BigManRaffa/Clementine/bringup/README.md

# Clementine Pre-Silicon Validation

- ALU, decoder, lanes, fetch sequencer, register file, SPI slave, multiplier, and mask stack end-to-end validated using a ESP32-S3 Devboard and a Gowin GW2AR FPGA (Sipeed Tang Nano 20K GW2AR-LV18QN88C8/I7).
- Inside [the host folder](bringup/host), a custom combined assembler + loader and a 39-kernel test suite were used to validate the entire ISA, grouped into per-lane identity, datapath, divergence, reverse-highway forms, and edge case tests.

## Validation Setup Diagrams

### Kernel Validation
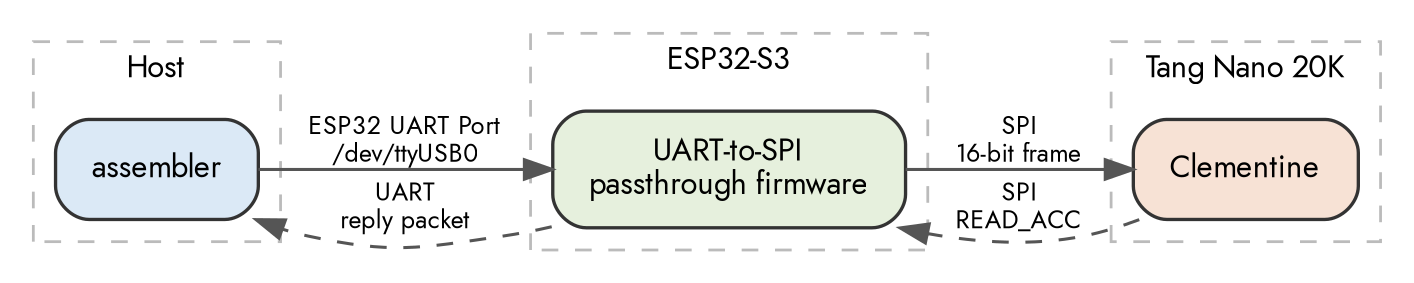
[picture p10: docs/bringup_diagram.png]
bringup diagram image


- The combined assembler + loader assembles a kernel and streams it to the ESP32 UART port one command per packet.

- The UART-to-SPI passthrough firmware on the ESP32 then unwraps each packet, drives the opcode onto Clementine's three command pins, and clocks the payload out over SPI.

- Clementine then loads each instruction word into its 8-slot buffer, runs the kernel across four lanes once the assembler tells it to start, and holds the results in its four accumulators. 

- The assembler polls until the chip reports it has halted, then requests each lane in turn, shifting that accumulator out on MISO for the ESP32 firmware to return as a UART reply packet.

### DOOM Desktop Demo

doom dataflow image

- The header generators bake the DOOM1.WAD into three headers, E1M1's BSP tree and per wall segment sector heights, a Q0.7 sine table, and the HUD as RGB565, which are then compiled into the sketch and flashed over the ESP32 UART Port. 

- The doom_driver handles visibility and marshalling. It walks the BSP tree front-to-back so nearer walls claim columns first, culls backfacing wall segments before spending a single SPI frame on them, then packs each wall's endpoints into int8 camera-relative coordinates and streams them over SPI as EXEC and BUFFER frames.

- Clementine takes those endpoints and does every multiply and divide that puts a wall on screen. It rotates two wall segments at once across its four lanes, dividing by multiplying with a reciprocal, projects each ceiling and floor to a screen row, then computes coverage for every wall edge with SIMT MAC instructions, working out how much of the boundary cell the wall actually covers.

- The driver reads those rows back over MISO and does the scan conversion, filling the cells between edges Clementine returned, then drives the panel by comparing the character grid against the previous frame and blitting only the runs that changed. 

- Those pixels leave as READ_ACC transactions on the same MISO line the ST7789 listens on, so every byte the panel receives is shifted out of Clementine's accumulator.

## Validation Setup image

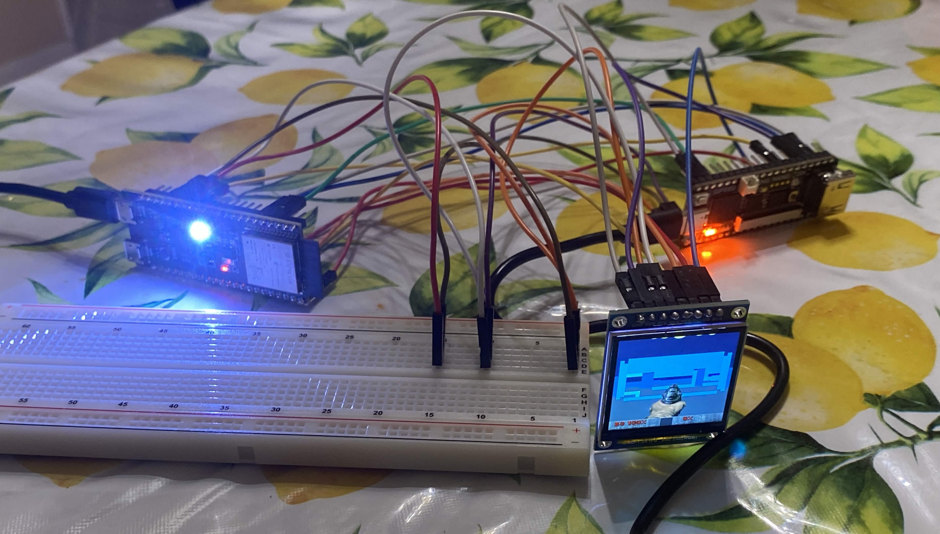
[picture p11: docs/bringup.jpg]
bringup image


## Old Demo

https://github.com/user-attachments/assets/2a935765-3c63-42a5-b818-157d14847543

## Breadboard Setup

### Wiring

Three shared-bus nodes, each one breadboard column with three wires:

| Node | Driver | Listeners |
|---|---|---|
| SCLK | ESP32 GPIO12 | Tang pin 73, LCD SCL |
| MISO | Tang pin 75 | ESP32 GPIO13, LCD SDA |
| MOSI | ESP32 GPIO11 | Tang pin 74 |

Point-to-point:

| Signal | ESP32 | Tang Nano 20K |
|---|---|---|
| CS_N | GPIO9 | pin 76 |
| CMD0 | GPIO4 | pin 86 |
| CMD1 | GPIO5 | pin 72 |
| CMD2 | GPIO6 | pin 71 |
| GND | G | GND |

| LCD | Connects to |
|---|---|
| CS | ESP32 GPIO38 |
| DC | ESP32 GPIO42 |
| RES | ESP32 GPIO41 |
| VCC | Tang 3V3 |
| BLK | Tang 3V3 |
| GND | Tang GND |

On-board, no wires: clk = Tang pin 4 (27 MHz oscillator, PLL'd to 40.5 MHz), rst_n = pin 88 (button S1), LEDs = pins 15-18.

This setup ALSO works for the assembler + kernel tests aswell.

## Doom Handheld Demo

## Handheld

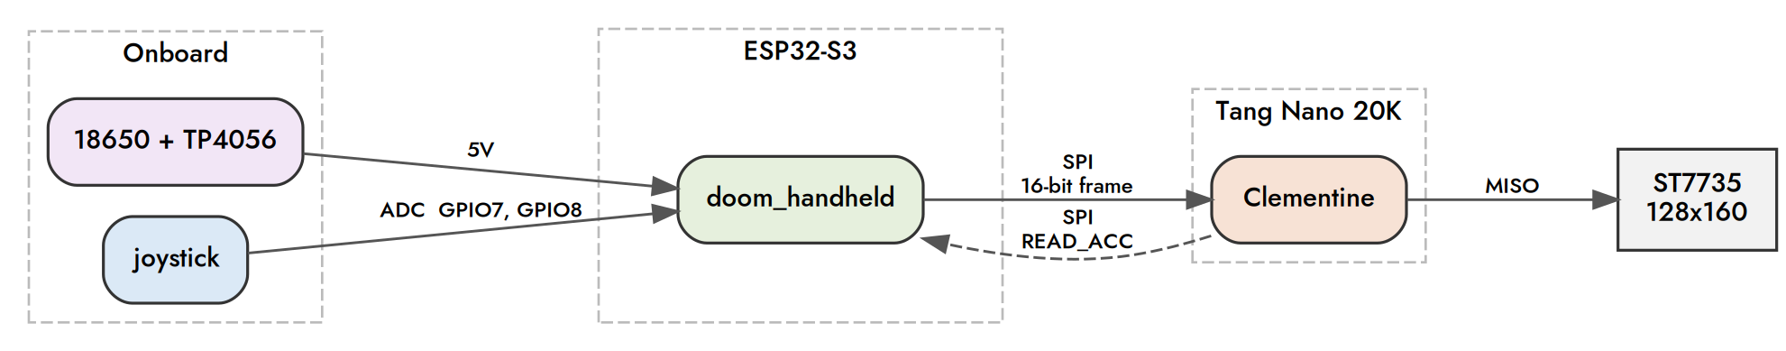
[picture p12: docs/handheld_dataflow.png]
handheld data flow


* Same renderer, retargeted to a 128x160 ST7735 and made self contained. The
  laptop is gone, so there is no `walk.py`, no UART, and no serial input at
  all.

* The panel changes are two bytes and a grid. ST7735 wants `0x05` for RGB565
  where ST7789 wants `0x55`, and inversion off instead of on. Cells drop from
  8 pixels to 4, so a 32 by 40 grid fills the screen exactly with no
  letterboxing. The projection scale rises to keep the same field of view now
  that the screen is half as wide.

* Movement comes off an analog stick on two ADC pins. Every stick rests
  slightly off centre, so the firmware samples the resting position once at
  boot rather than assuming the midpoint. Do not touch it while it powers up.

* Each frame averages a burst of samples and runs them through a low pass,
  because a single ADC read swings tens of counts on a stick that has not
  moved. These gimbals also put a real signal on the other axis when pushed
  diagonally, which is enough to make a turn walk you backwards, so the axis
  you are not pushing has to clear a much higher threshold before it counts.

* The status bar is scaled so its height and width shrink by different amounts,
  because squeezing 320 pixels of bar into 128 leaves the digits unreadable at
  a uniform scale.

## Handheld image

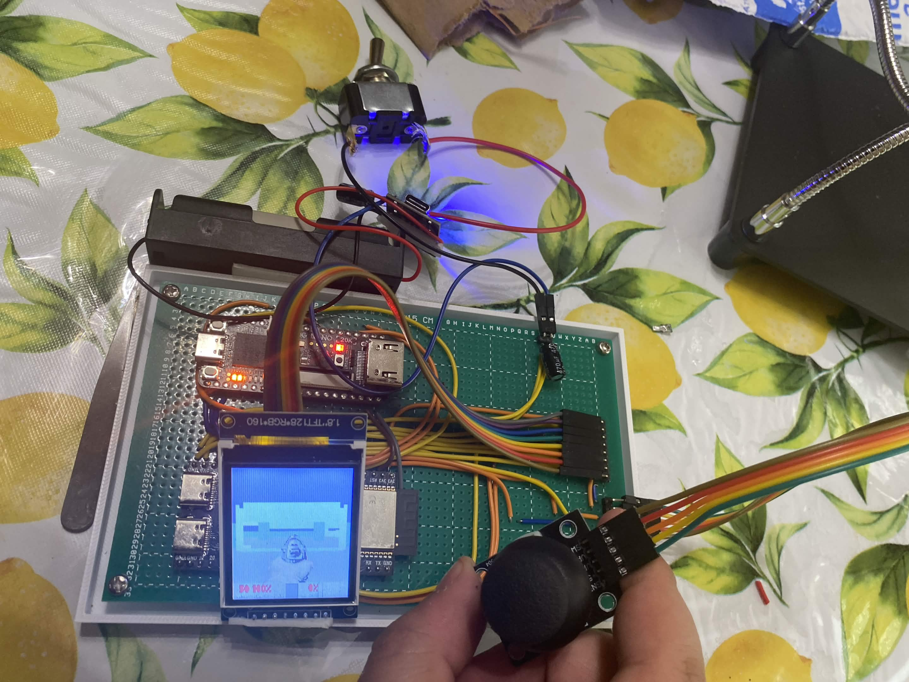
[picture p13: docs/handheld_image.jpg]
handheld data flow


Yes I used a SPST made for a car as my off switch please dont laugh at me.

### Wiring

Everything from the bench setup is unchanged. Three shared bus nodes, the four
command pins, and the LCD all wire as before. Two additions:

| Joystick | ESP32-S3 |
|---|---|
| GND | GND |
| +5V | 3V3 |
| VRX | GPIO7 |
| VRY | GPIO8 |
| SW  | GPIO14 |

The joystick's `+5V` pin is really VCC. The module is two potentiometers with
no regulator, so its output swings to whatever it is fed, and the ADC pins are
not 5V tolerant.

| Power | Connects to |
|---|---|
| TP4056 OUT+ | switch, then ESP32 5V and Tang 5V |
| TP4056 OUT- | ESP32 GND and Tang GND |

GPIO7 and GPIO8 are on ADC1, which keeps working when WiFi is enabled. ADC2
does not.

## Issues found

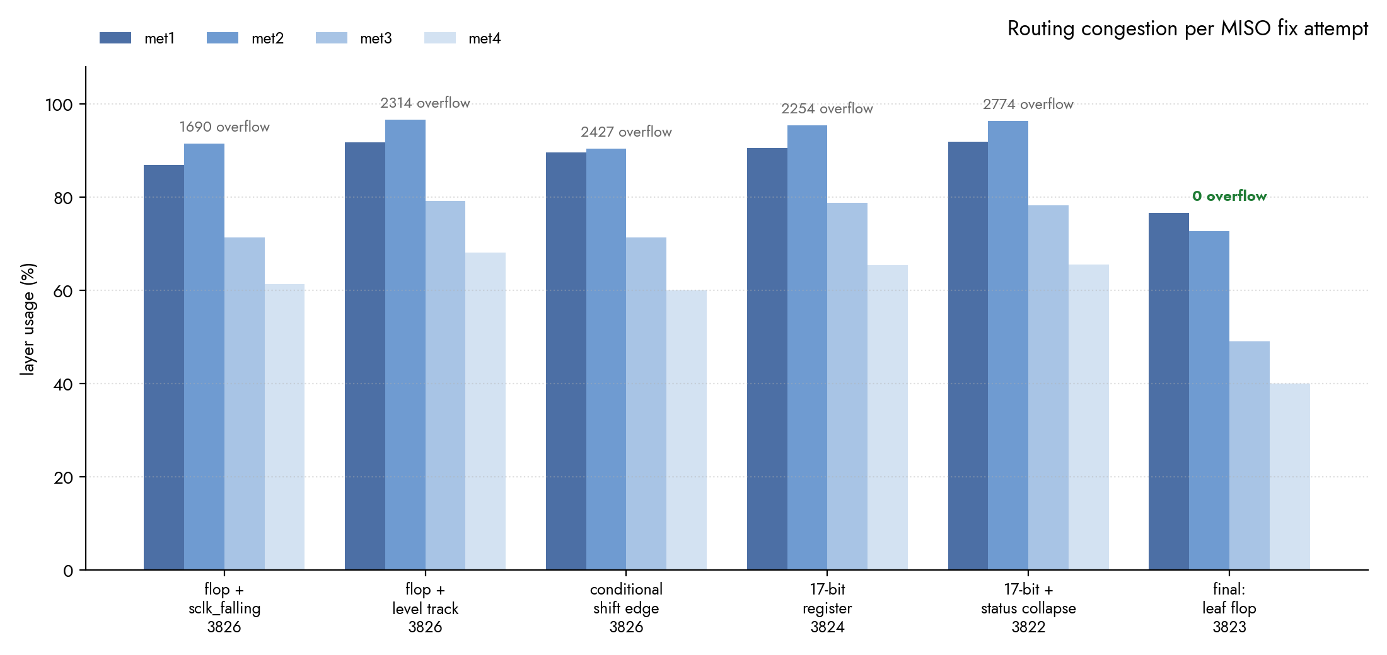
[picture p14: docs/congestion.png]
SPI debugging graph


- During Pre-Silicon Validation, a bug in the SPI module was found that the cocotb testbenches missed, MISO updated on the SCLK rising edge, the same one that master samples on. MISO was wired directly to the top bit of the shift register, with nothing in between. When the register shifted, MISO changed immediately, on the same clock edge the ESP32 was reading it. The master kept catching the next bit instead of the current one so every value came back doubled. 

    - To fix this, I first tried a dedicated miso_out flop that loaded the top of the selected read-back value at CS-fall and advanced on a new sclk_falling edge detector, which worked on the hardware pushed congestion from 61% to 81% with 1,690 overflow. 
    - Suspecting that the edge detector was the cost, I replaced it with a  simple check for whether the clock line was low, so the flop tracked the register the whole time SCLK was low and froze while it was high. Same cell count, but congestion got worse at 87% and 2314 overflow. 
    - I then tried removing the flop entirely with a combinational mux, which came in at 3,823 cells and routed, but failed on the hardware because after N shifts the bit the master needs has already left the register and no mux over it can recover a bit that no longer exists.
    - Next, I made the shift edge itself conditional so the MOSI captured stayed on the rising edge while reads shifted on the failing one, which worked on the hardware but still routed at 81% with 2427 overflow. I tried widening data_register to 17 bits so the extra position absorbed the master's late sample, which worked, and collapsing the redundant ~sequencer_done status bit brought it to exactly 3,822 cells, but the congestion was the worst out of any attempt at 86% and 2,774 overflow. 
    - The working solution was going back to the dedicated MISO flop updating on the falling edge, dropping its reset, keeping the redundant status bit deleted, and restoring the guard that stops the shift register moving during per-lane staging frames. It resulted in 3,823 cells, 63.89% congestion, and zero overflow.

For the DOOM issues, see [doomdev.md](demo/doom/doomdev.md).
