BigManRaffa/Clementine/bringup/TangNano20K/GW2AR/src/clm_fa.v

module clm_fa (
    input wire a,
    input wire b,
    input wire cin,
    output wire sum,
    output wire cout
);

wire axb;

    assign axb = a ^ b;
    assign sum = axb ^ cin;
    assign cout = axb ? cin : a;

endmodule
