BigManRaffa/Clementine/(commit log)

2026-07-21 fix info.yaml metadata, docs sections, tb module name
    [tb.v]
2026-08-04 mask and lane, i think I forgot a case with lane
2026-08-04 fixing weird vscode formatting issue, hate this alignment padding it adds for me
    [clm_alu.v, clm_lane.v, clm_mask_stack.v, clm_mult_bw.v, clm_regfile.v]
2026-08-06 most horrendous sequencer ever, anything to avoid a mux
    [clm_fetch_seq.v]
2026-08-06 i spi with my little eye (is this an overdone joke?
2026-08-07 test 3, 65%, routing fixes
    [clm_decoder.v, clm_fetch_seq.v, clm_lane.v, clm_spi_host.v, tt_um_bigmanraffa_clm.v]
2026-08-07 test 4, 65%, more routing fixes
    [tt_um_bigmanraffa_clm.v]
2026-08-07 revert to 88% utilization stage
    [clm_decoder.v, clm_lane.v, clm_spi_host.v, tt_um_bigmanraffa_clm.v]
2026-08-08 Test 11%, Hard architecture change. MCU dependent SPI host now
2026-08-08 Test 15, 65%, error fix
    [clm_decoder.v]
2026-08-09 Test 16, 65%, SPIcy SPI changes (and architecture) changes
2026-08-09 Test 17, 65%, SPIcy SPI changes architecture changes + fixing a comma
    [tt_um_bigmanraffa_clm.v]
2026-08-09 Test 18, 65%, fixing.. verilog bugs...
    [clm_decoder.v, tt_um_bigmanraffa_clm.v]
2026-08-09 Test 23, updating SPI, fixing timing issues with this testbench
    [test.py]
2026-08-09 Test 24, fixing spi delayed by 1.
    [clm_spi_host.v]
2026-08-09 Test 26, I am not a fan of SPI.
2026-08-11 Bringup, assembler + kernels
2026-08-12 ESP32 firmware
2026-08-15 FPGA Test 6, trial and error.
    [clm_spi_host.v]
